NoelGaspar/cinnda_oval_hardware/board/Output_files/oval_v5.step

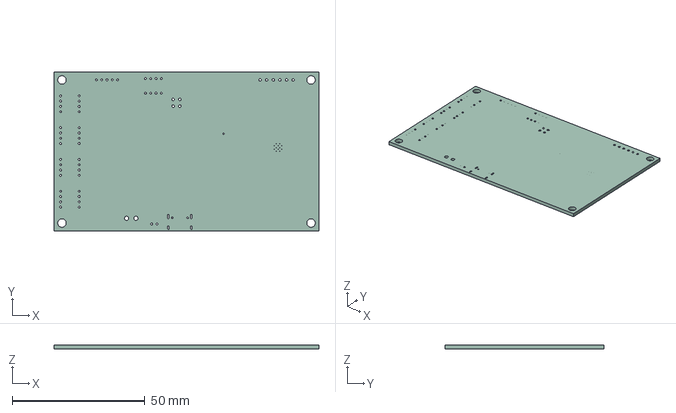
[picture p1: CAD file, 2026-07-07]
board/Output_files/oval_v5.step
100.0 x 60.0 x 1.51 mm
