NoelGaspar/cinnda_oval_hardware/board/oval_v5.kicad_pcb

## KiCad design board/oval_v5.kicad_pcb (2026-07-07)

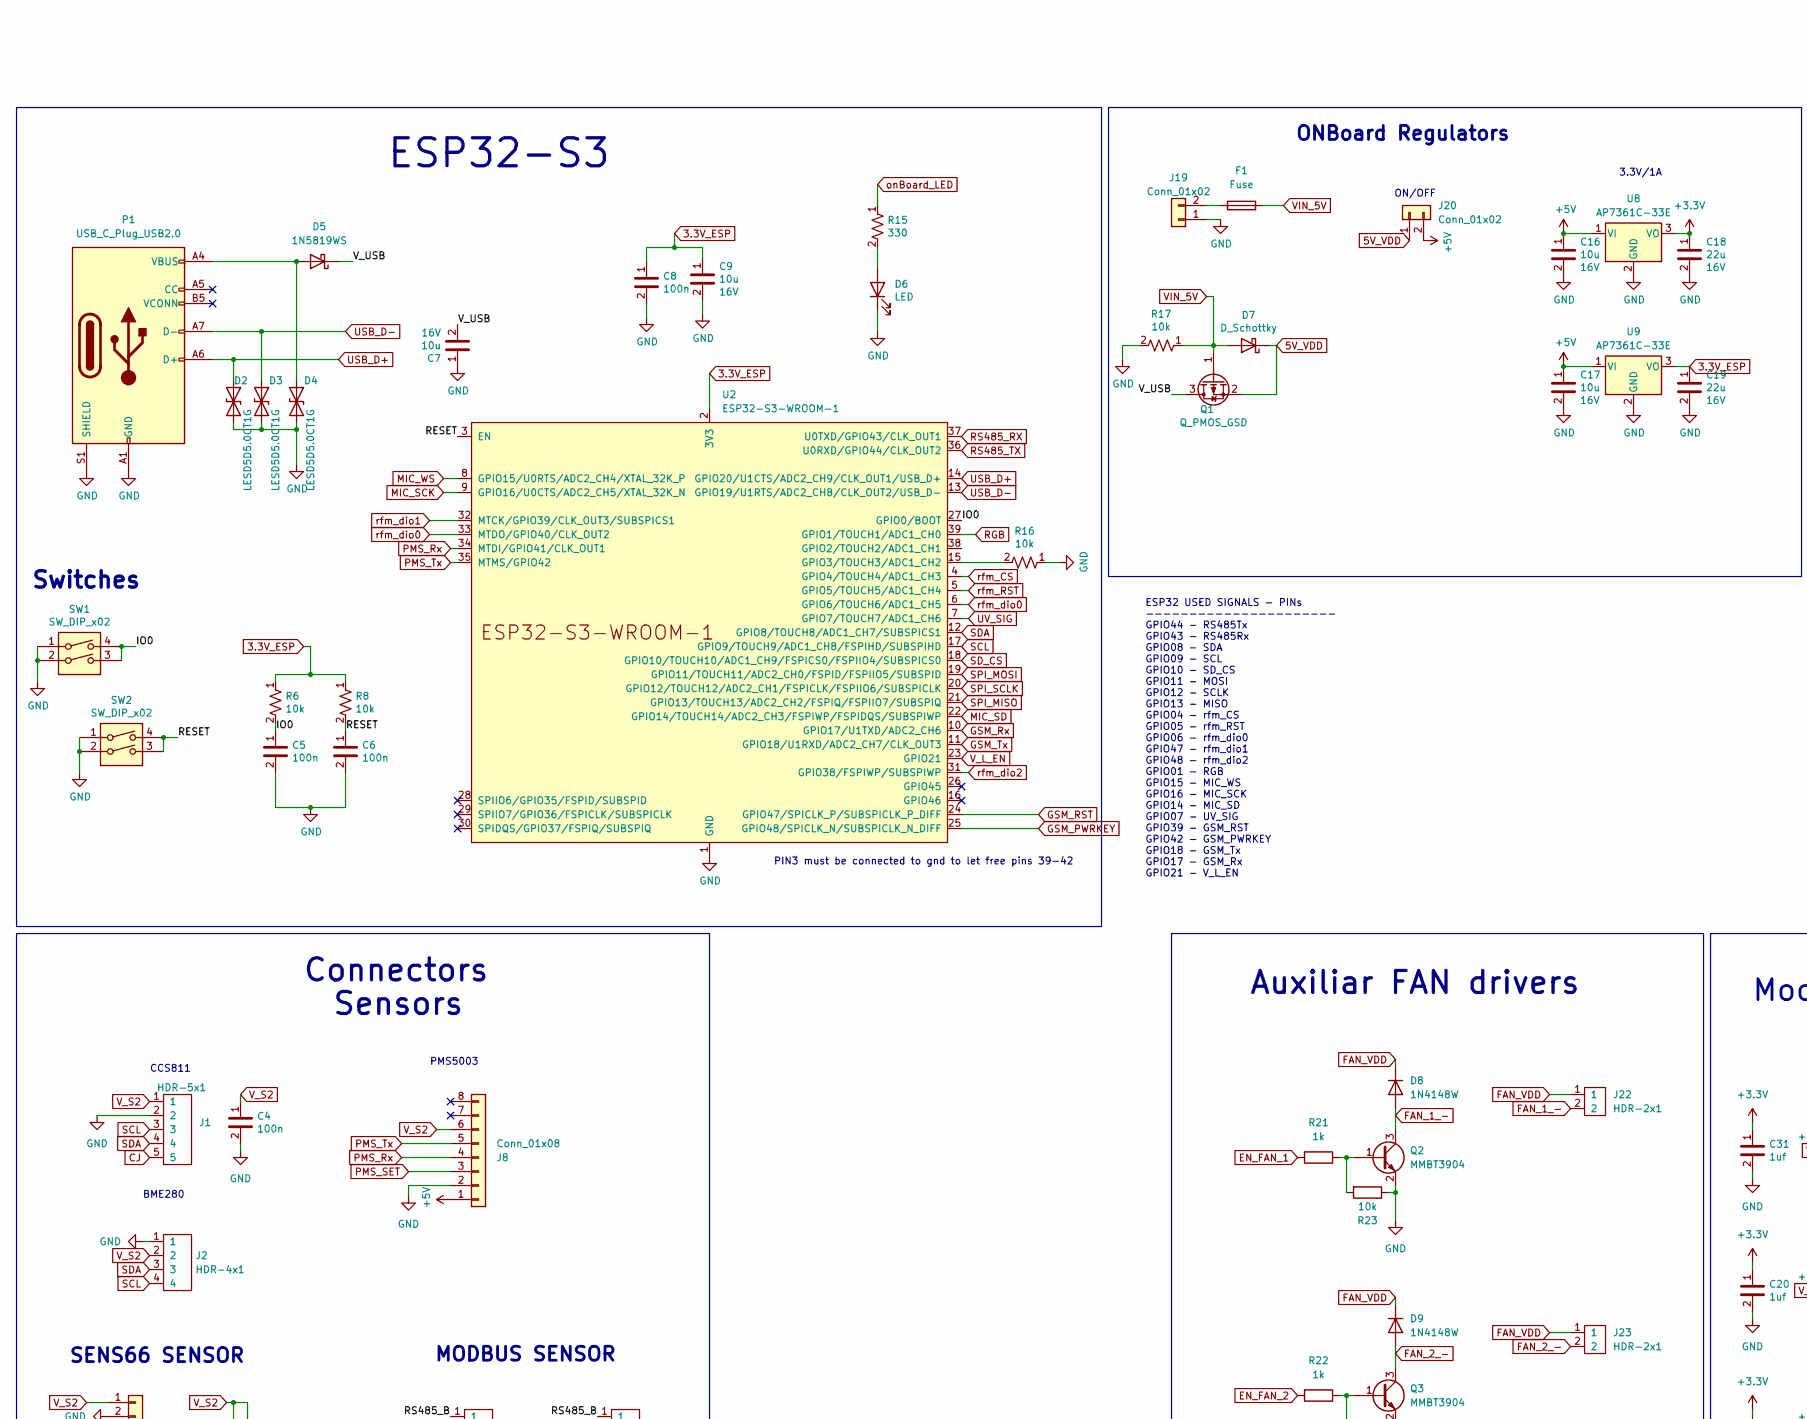
[picture p2: schematic oval_v5.kicad_sch, part in row 1, column 1]

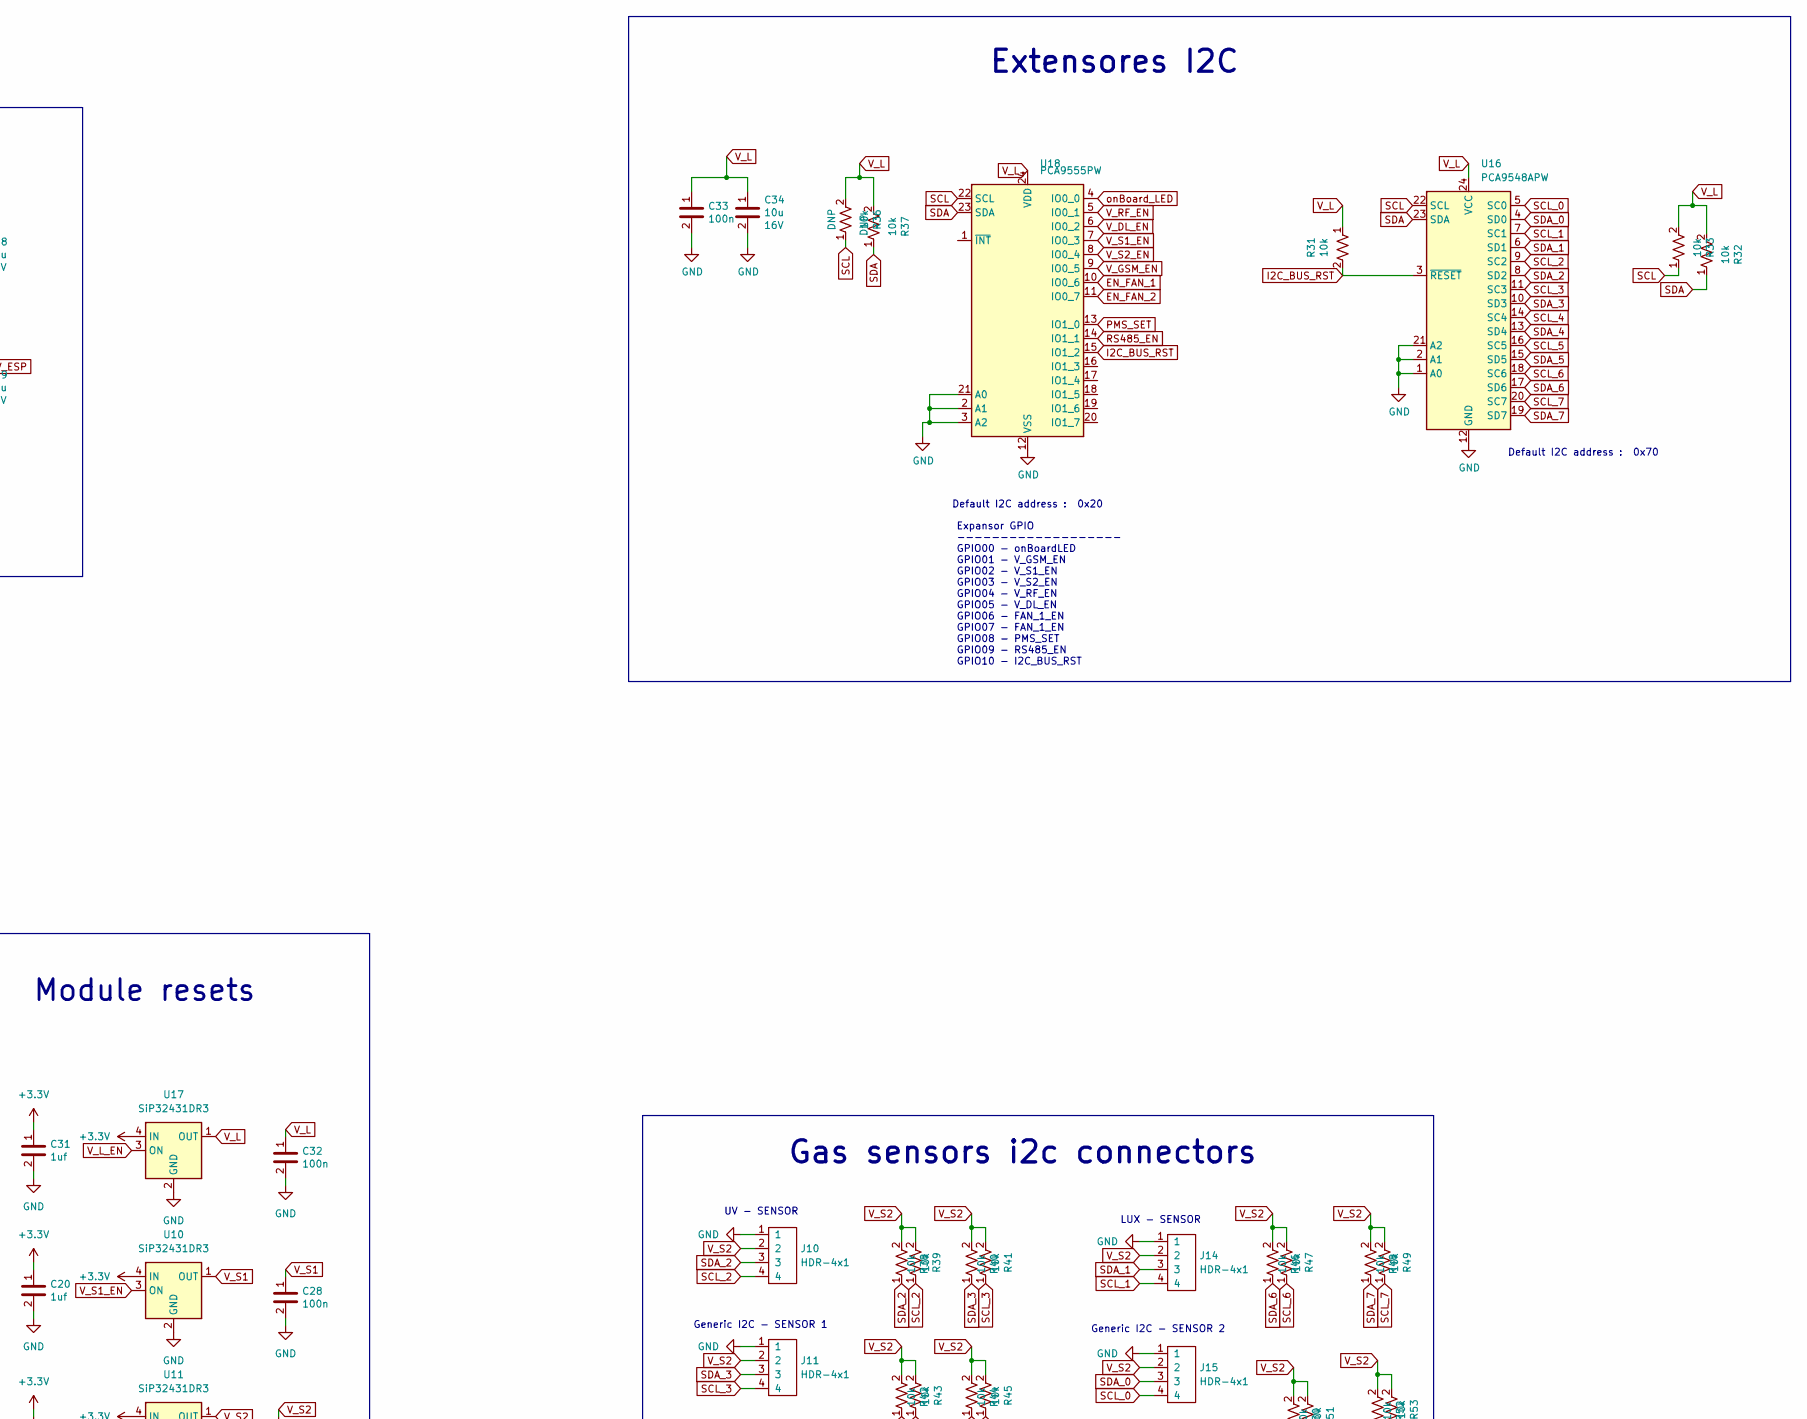
[picture p3: schematic oval_v5.kicad_sch, part in row 1, column 2]

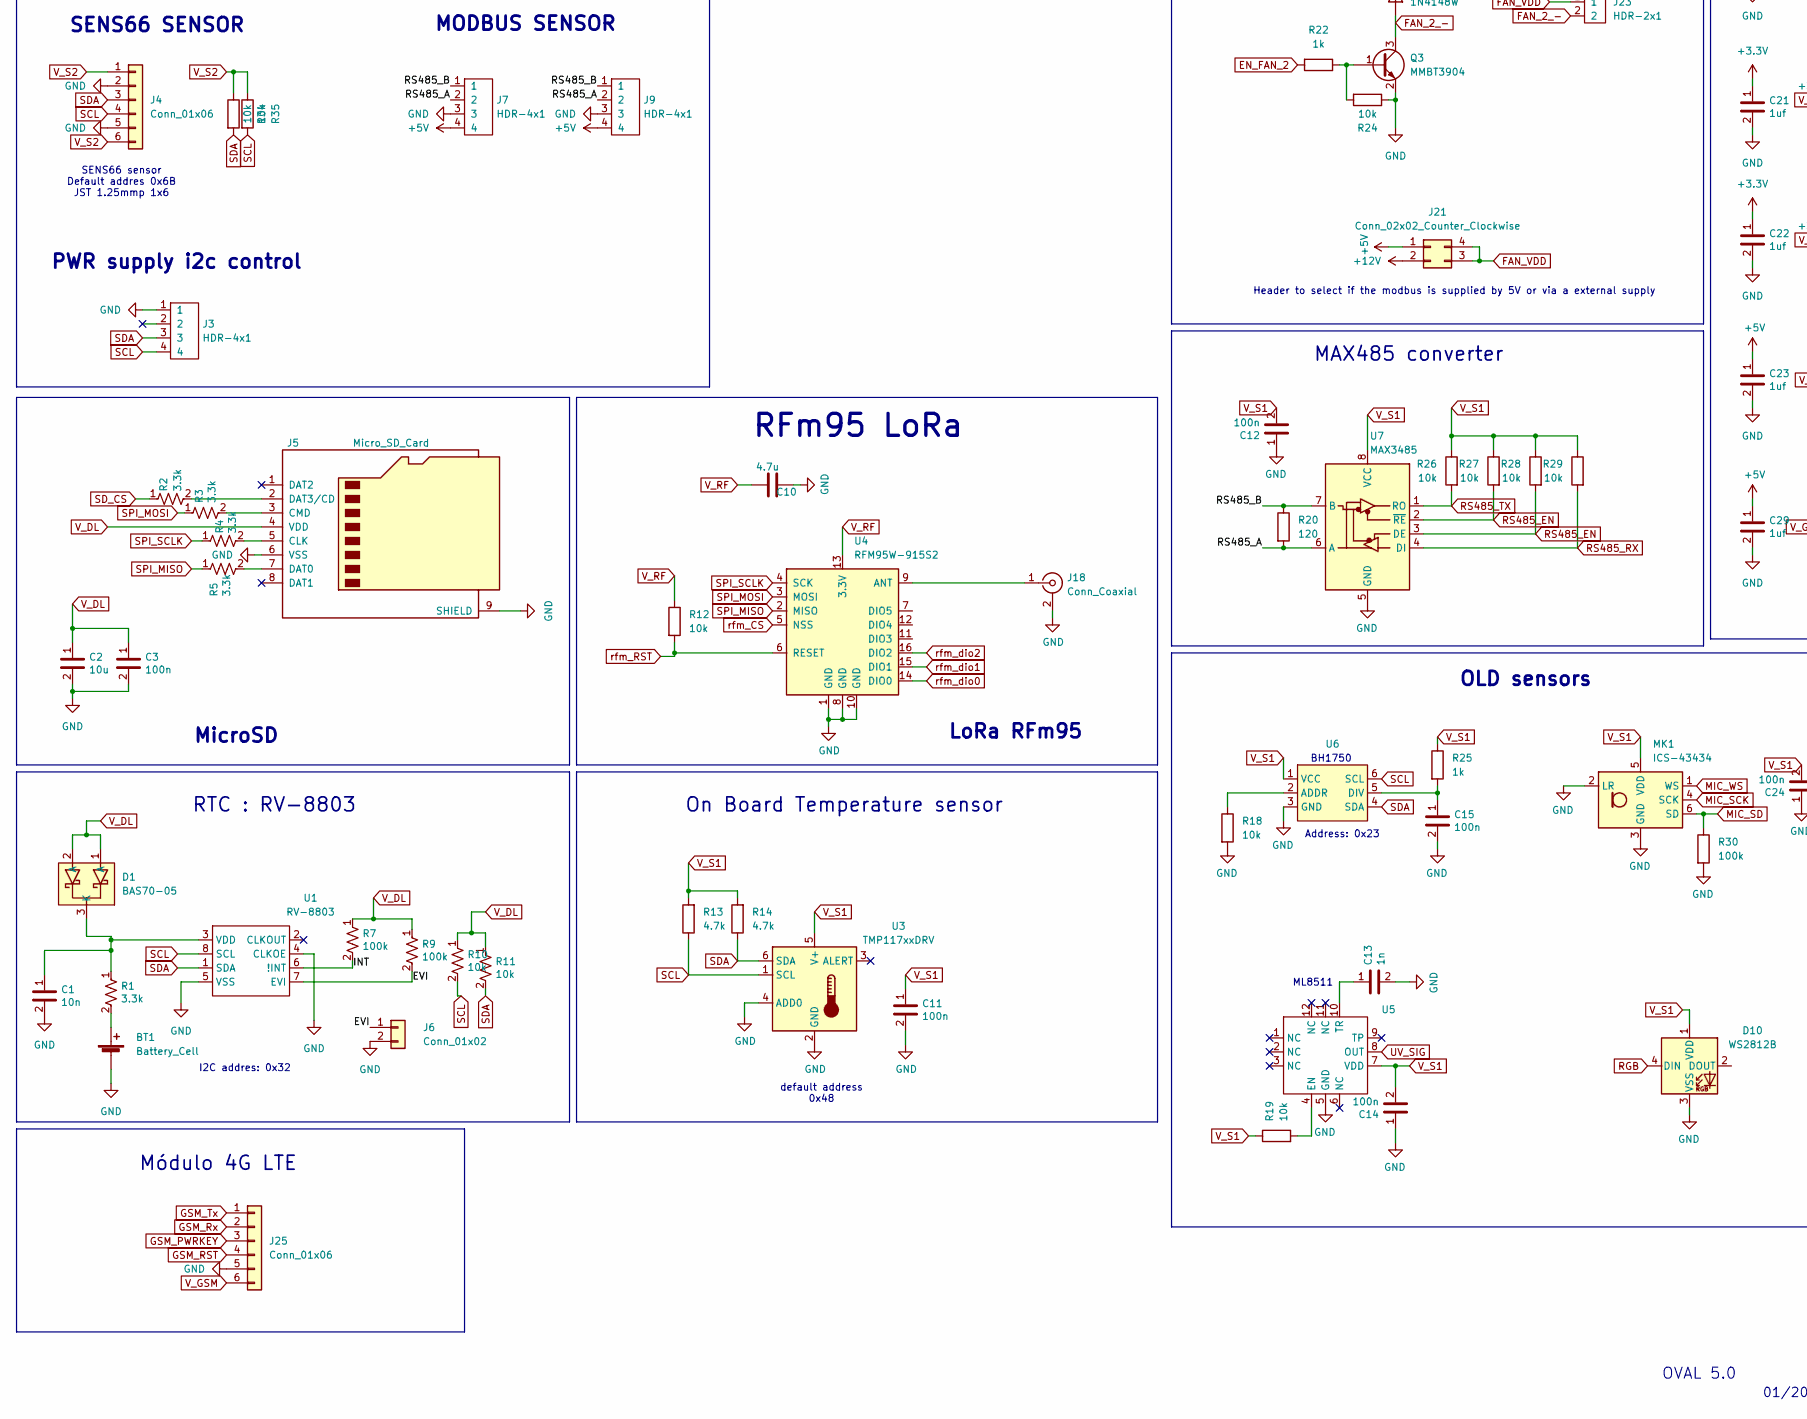
[picture p4: schematic oval_v5.kicad_sch, part in row 2, column 1]

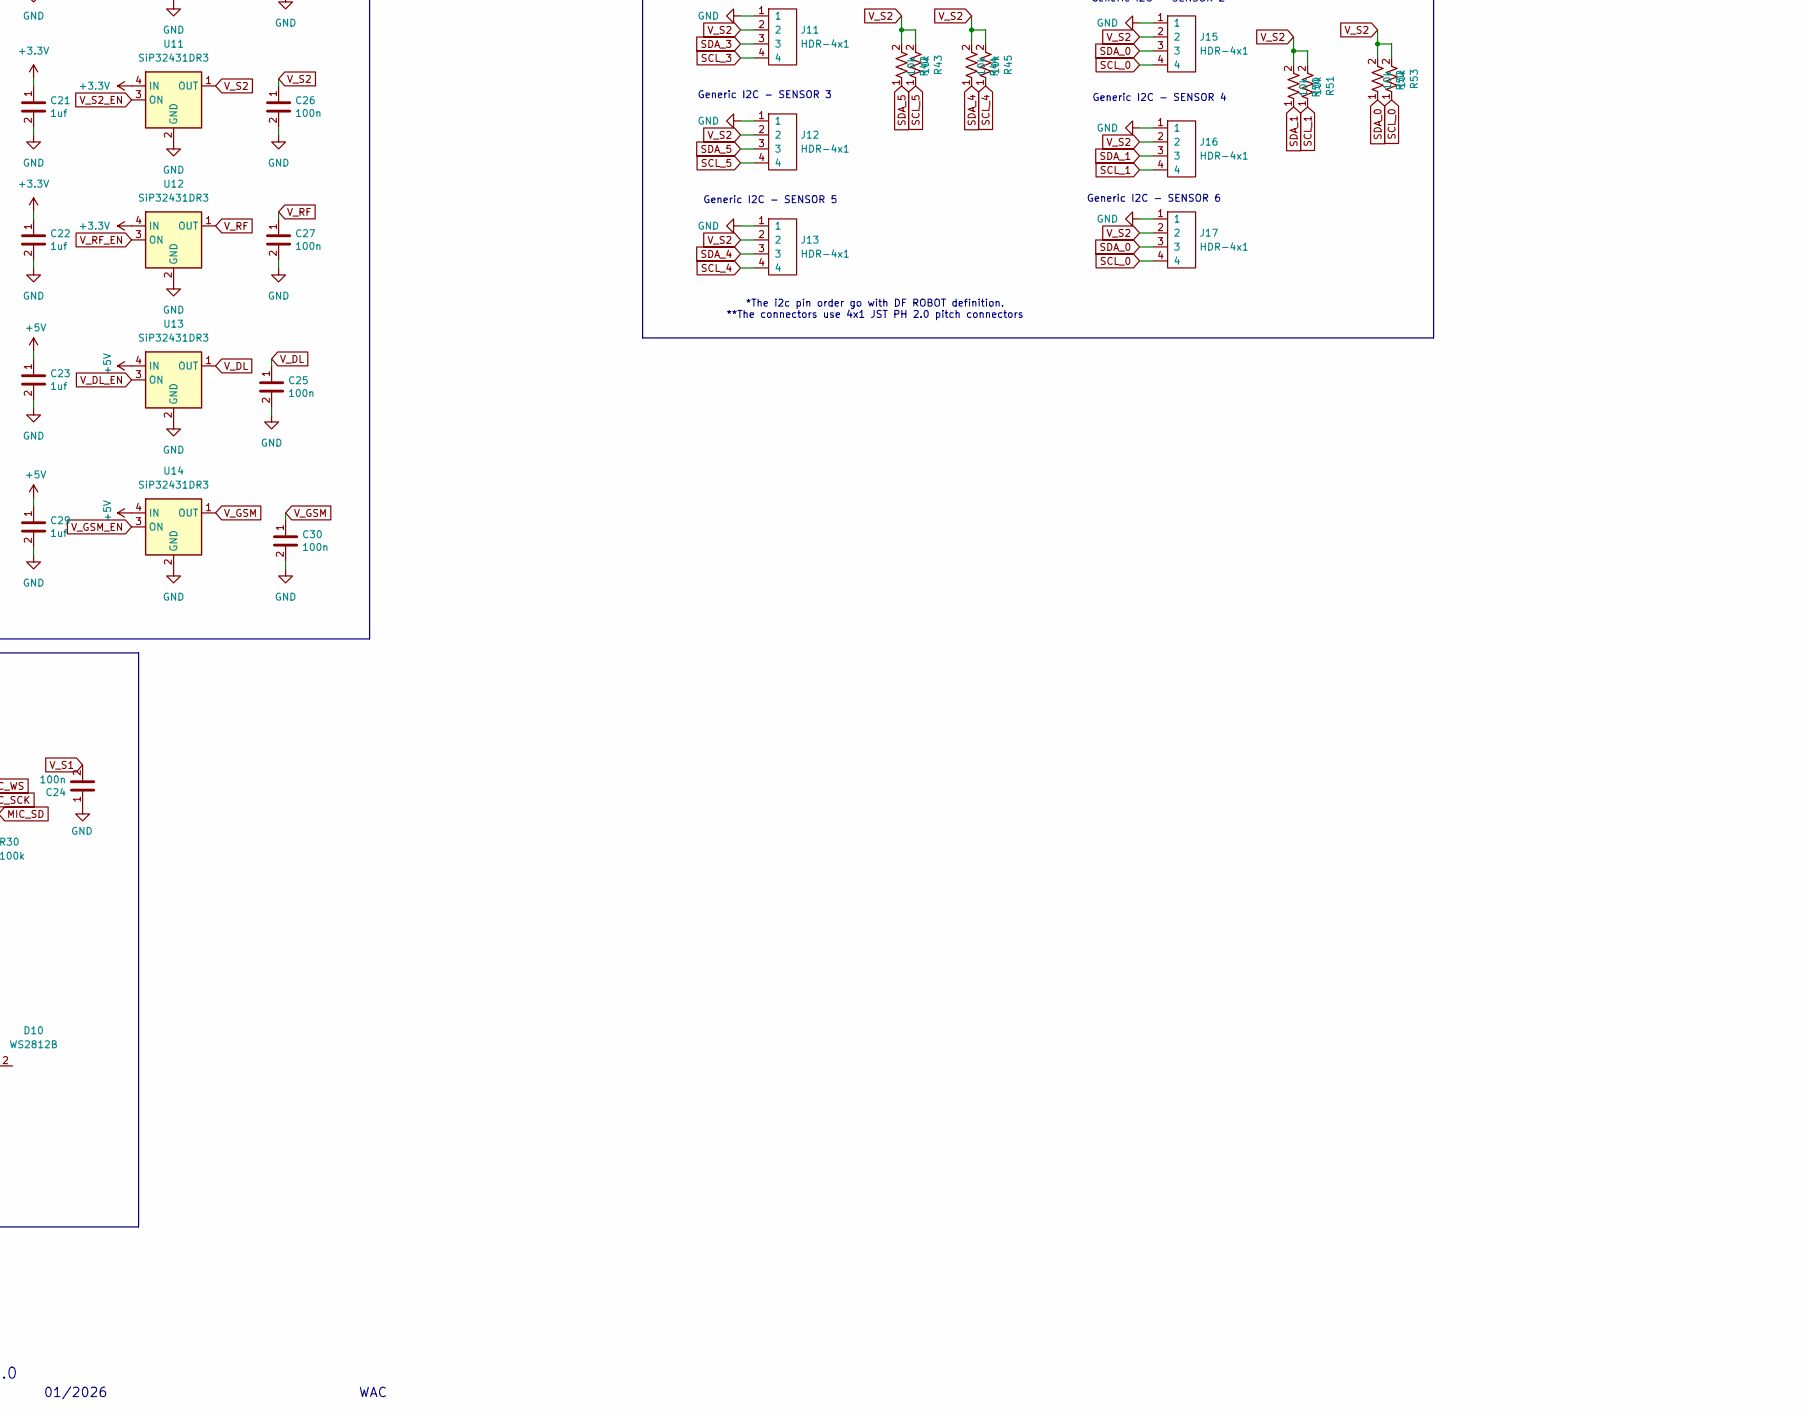
[picture p5: schematic oval_v5.kicad_sch, part in row 2, column 2]

Parts:
BT1: Battery_Cell; BatteryHolder_Keystone_3000_1x12mm
C1: 10n; C_0603_1608Metric; Voltage rated 16V
C2, C7, C9, C16, C17, C34: 10u; C_0805_2012Metric; Voltage rated 16V
C3, C4, C5, C6, C8, C11, C12, C14, C15, C24, C25, C26, C27, C28, C30, C32, C33: 100n; C_0603_1608Metric; Voltage rated 16V
C10: 4.7u; C_0805_2012Metric
C13: 1n; C_0603_1608Metric; Voltage rated 16V
C18, C19: 22u; C_0805_2012Metric; Voltage rated 16V
C20, C21, C22, C23, C29, C31: 1uf; C_0805_2012Metric; Voltage rated 16V
D1: BAS70-05; SOT-23
D2, D3, D4: LESD5D5.0CT1G; D_SOD-523
D5: 1N5819WS; D_SOD-323_HandSoldering
D6: LED; LED_0603_1608Metric
D7: D_Schottky; D_SMA
D8, D9: 1N4148W; D_SOD-123
D10: WS2812B; LED_WS2812B_PLCC4_5.0x5.0mm_P3.2mm
F1: Fuse; Fuse_1206_3216Metric
J1: HDR-5x1; JST_PH_B5B-PH-K_1x05_P2.00mm_Vertical
J2, J3: HDR-4x1; JST_SH_SM04B-SRSS-TB_1x04-1MP_P1.00mm_Horizontal
J4: Conn_01x06; JST_GH_SM06B-GHS-TB_1x06-1MP_P1.25mm_Horizontal
J5: Micro_SD_Card; microSD_HC_Wuerth_693072010801
J6: Conn_01x02; SolderJumper-2_P1.3mm_Open_RoundedPad1.0x1.5mm
J7, J9, J10, J11, J12, J13, J14, J15, J16, J17: HDR-4x1; JST_PH_B4B-PH-K_1x04_P2.00mm_Vertical
J8: Conn_01x08; Molex_PicoBlade_53261-0871_1x08-1MP_P1.25mm_Horizontal
J18: Conn_Coaxial; U.FL_Molex_MCRF_73412-0110_Vertical
J19: Conn_01x02; Wago_734-132_1x02_P3.50mm_Vertical
J20: Conn_01x02; JST_PH_B2B-PH-K_1x02_P2.00mm_Vertical
J21: Conn_02x02_Counter_Clockwise; PinHeader_2x02_P2.54mm_Vertical
J22, J23: HDR-2x1; JST_PH_S2B-PH-SM4-TB_1x02-1MP_P2.00mm_Horizontal
J25: Conn_01x06; JST_PH_B6B-PH-K_1x06_P2.00mm_Vertical
MK1: ICS-43434; InvenSense_ICS-43434-6_3.5x2.65mm
P1: USB_C_Plug_USB2.0; USB_C_Receptacle_GCT_USB4105-xx-A_16P_TopMnt_Horizontal
Q1: Q_PMOS_GSD; SOT-23
Q2, Q3: MMBT3904; SOT-23
R1, R2, R3, R4, R5: 3.3k; R_0603_1608Metric
R6, R8, R10, R11, R12, R16, R17, R18, R19, R23, R24, R26, R27, R28, R29, R31, R32, R33, R34, R35, R36, R37, R38, R39, R40, R41, R42, R43, R44, R45, R46, R47, R48, R49, R50, R51, R52, R53: 10k; R_0603_1608Metric
R7, R9, R30: 100k; R_0603_1608Metric
R13, R14: 4.7k; R_0603_1608Metric
R15: 330; R_0603_1608Metric
R20: 120; R_0603_1608Metric
R21, R22, R25: 1k; R_0603_1608Metric
SW1, SW2: SW_DIP_x02; SMD_SWITCH
U1: RV-8803; SON-8
U2: ESP32-S3-WROOM-1
U3: TMP117xxDRV; WSON-6-1EP_2x2mm_P0.65mm_EP1x1.6mm
U4: RFM95W-915S2; HOPERF_RFM9XW_SMD
U5: C-TQFN12-4.0x3.7-1
U6: WSOF6I
U7: MAX3485; SOP-8_3.9x4.9mm_P1.27mm
U8, U9: AP7361C-33E; SOT-223-3_TabPin2
U10, U11, U12, U13, U14, U17: SiP32431DR3; SOT-363_SC-70-6
U16: PCA9548APW; TSSOP-24_4.4x7.8mm_P0.65mm
U18: PCA9555PW; TSSOP-24_4.4x7.8mm_P0.65mm

Connections:
3.3V_ESP: C8.1, C9.1, C19.1, R6.1, R8.1, U2.2 (3V3), U9.3 (VO)
5V_VDD: D7.1 (K), J20.1, Q1.2 (S)
+3.3V: C18.1, C20.1, C21.1, C22.1, C31.1, U8.3 (VO), U10.4 (IN), U11.4 (IN), U12.4 (IN), U17.4 (IN)
+5V: C16.1, C17.1, C23.1, C29.1, J7.4, J8.1, J9.4, J20.2, J21.1, U8.1 (VI), U9.1 (VI), U13.4 (IN), U14.4 (IN)
+12V: J21.2
/EVI: J6.1, R9.2, U1.7 (EVI)
/INT: R7.2, U1.6 (!INT)
/IO0: C5.1, R6.2, SW1.3, SW1.4, U2.27 (GPIO0/BOOT)
/RESET: C6.1, R8.2, SW2.3, SW2.4, U2.3 (EN)
/RS485_A: J7.2, J9.2, R20.2, U7.6 (A)
/RS485_B: J7.1, J9.1, R20.1, U7.7 (B)
/V_USB: C7.2, D5.1 (K), Q1.3 (D)
CJ: J1.5
EN_FAN_1: R21.2, U18.10 (IO0_6)
EN_FAN_2: R22.2, U18.11 (IO0_7)
FAN_1_-: D8.2 (A), J22.2, Q2.3 (C)
FAN_2_-: D9.2 (A), J23.2, Q3.3 (C)
FAN_VDD: D8.1 (K), D9.1 (K), J21.3, J21.4, J22.1, J23.1
GND: BT1.2 (-), C1.2, C2.2, C3.2, C4.2, C5.2, C6.2, C7.1, C8.2, C9.2, C10.1, C11.2, C12.1, C13.2, C14.1, C15.2, C16.2, C17.2, C18.2, C19.2, C20.2, C21.2, C22.2, C23.2, C24.1, C25.2, C26.2, C27.2, C28.2, C29.2, C30.2, C31.2, C32.2, C33.2, C34.2, D2.2 (A2), D3.2 (A2), D4.2 (A2), D6.1 (K), D10.3 (VSS), J1.2, J2.1, J3.1, J4.2, J4.5, J5.6 (VSS), J5.9 (SHIELD), J6.2, J7.3, J8.2, J9.3, J10.1, J11.1, J12.1, J13.1, J14.1, J15.1, J16.1, J17.1, J18.2 (Ext), J19.1, J25.5, MK1.2 (LR), MK1.3 (GND), P1.A1 (GND), P1.A12 (GND), P1.B1 (GND), P1.B12 (GND), P1.S1 (SHIELD), Q2.2 (E), Q3.2 (E), R16.1, R17.2, R18.2, R23.1, R24.1, R30.2, SW1.1, SW1.2, SW2.1, SW2.2, U1.4 (CLKOE), U1.5 (VSS), U2.1 (GND), U2.40 (GND), U2.41 (GND), U3.2 (GND), U3.4 (ADD0), U4.1 (GND), U4.8 (GND), U4.10 (GND), U5.5 (GND), U6.3 (GND), U7.5 (GND), U8.2 (GND), U9.2 (GND), U10.2 (GND), U10.5 (GND), U11.2 (GND), U11.5 (GND), U12.2 (GND), U12.5 (GND), U13.2 (GND), U13.5 (GND), U14.2 (GND), U14.5 (GND), U16.1 (A0), U16.2 (A1), U16.12 (GND), U16.21 (A2), U17.2 (GND), U17.5 (GND), U18.2 (A1), U18.3 (A2), U18.12 (VSS), U18.21 (A0)
GSM_PWRKEY: J25.3, U2.25 (GPIO48/SPICLK_N/SUBSPICLK_N_DIFF)
GSM_RST: J25.4, U2.24 (GPIO47/SPICLK_P/SUBSPICLK_P_DIFF)
GSM_Rx: J25.2, U2.10 (GPIO17/U1TXD/ADC2_CH6)
GSM_Tx: J25.1, U2.11 (GPIO18/U1RXD/ADC2_CH7/CLK_OUT3)
I2C_BUS_RST: R31.2, U16.3 (~RESET), U18.15 (IO1_2)
MIC_SCK: MK1.4 (SCK), U2.9 (GPIO16/U0CTS/ADC2_CH5/XTAL_32K_N)
MIC_SD: MK1.6 (SD), R30.1, U2.22 (GPIO14/TOUCH14/ADC2_CH3/FSPIWP/FSPIDQS/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)
MIC_WS: MK1.1 (WS), U2.8 (GPIO15/U0RTS/ADC2_CH4/XTAL_32K_P)
unnamed: BT1.1 (+), R1.2
unnamed: C1.1, D1.3 (K), R1.1, U1.3 (VDD)
unnamed: D4.1 (A1), D5.2 (A), P1.A4 (VBUS), P1.A9 (VBUS), P1.B4 (VBUS), P1.B9 (VBUS)
unnamed: D6.2 (A), R15.2
unnamed: J5.5 (CLK), R4.2
unnamed: J5.3 (CMD), R3.2
unnamed: J5.7 (DAT0), R5.2
unnamed: J5.2 (DAT3/CD), R2.2
unnamed: J18.1 (In), U4.9 (ANT)
unnamed: F1.1, J19.2
unnamed: Q2.1 (B), R21.1, R23.2
unnamed: Q3.1 (B), R22.1, R24.2
unnamed: R16.2, U2.15 (GPIO3/TOUCH3/ADC1_CH2)
unnamed: R19.2, U5.4 (EN)
unnamed: C13.1, U5.10 (TR)
unnamed: R18.1, U6.2 (ADDR)
unnamed: C15.1, R25.2, U6.5 (DIV)
PMS_Rx: J8.4, U2.34 (MTDI/GPIO41/CLK_OUT1)
PMS_SET: J8.3, U18.13 (IO1_0)
PMS_Tx: J8.5, U2.35 (MTMS/GPIO42)
RGB: D10.4 (DIN), U2.39 (GPIO1/TOUCH1/ADC1_CH0)
RS485_EN: R27.2, R28.2, U7.2 (~RE), U7.3 (DE), U18.14 (IO1_1)
RS485_RX: R29.2, U2.37 (U0TXD/GPIO43/CLK_OUT1), U7.4 (DI)
RS485_TX: R26.2, U2.36 (U0RXD/GPIO44/CLK_OUT2), U7.1 (RO)
SCL: J1.3, J2.4, J3.4, J4.4, R10.2, R13.1, R33.1, R35.2, R36.1, U1.8 (SCL), U2.17 (GPIO9/TOUCH9/ADC1_CH8/FSPIHD/SUBSPIHD), U3.1 (SCL), U6.6 (SCL), U16.22 (SCL), U18.22 (SCL)
SCL_0: J15.4, J17.4, R53.1, U16.5 (SC0)
SCL_1: J14.4, J16.4, R51.1, U16.7 (SC1)
SCL_2: J10.4, R39.1, U16.9 (SC2)
SCL_3: J11.4, R41.1, U16.11 (SC3)
SCL_4: J13.4, R45.1, U16.14 (SC4)
SCL_5: J12.4, R43.1, U16.16 (SC5)
SCL_6: R47.1, U16.18 (SC6)
SCL_7: R49.1, U16.20 (SC7)
SDA: J1.4, J2.3, J3.3, J4.3, R11.2, R14.1, R32.1, R34.2, R37.1, U1.1 (SDA), U2.12 (GPIO8/TOUCH8/ADC1_CH7/SUBSPICS1), U3.6 (SDA), U6.4 (SDA), U16.23 (SDA), U18.23 (SDA)
SDA_0: J15.3, J17.3, R52.1, U16.4 (SD0)
SDA_1: J14.3, J16.3, R50.1, U16.6 (SD1)
SDA_2: J10.3, R38.1, U16.8 (SD2)
SDA_3: J11.3, R40.1, U16.10 (SD3)
SDA_4: J13.3, R44.1, U16.13 (SD4)
SDA_5: J12.3, R42.1, U16.15 (SD5)
SDA_6: R46.1, U16.17 (SD6)
SDA_7: R48.1, U16.19 (SD7)
SD_CS: R2.1, U2.18 (GPIO10/TOUCH10/ADC1_CH9/FSPICS0/FSPIIO4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)
SPI_MISO: R5.1, U2.21 (GPIO13/TOUCH13/ADC2_CH2/FSPIQ/FSPIIO7/S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), U4.2 (MISO)
SPI_MOSI: R3.1, U2.19 (GPIO11/TOUCH11/ADC2_CH0/FSPID/FSPIIO5/S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), U4.3 (MOSI)
SPI_SCLK: R4.1, U2.20 (GPIO12/TOUCH12/ADC2_CH1/FSPICLK/FSPIIO6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), U4.4 (SCK)
USB_D+: D2.1 (A1), P1.A6 (D+), U2.14 (GPIO20/U1CTS/ADC2_CH9/CLK_OUT1/USB_D+)
USB_D-: D3.1 (A1), P1.A7 (D-), U2.13 (GPIO19/U1RTS/ADC2_CH8/CLK_OUT2/USB_D-)
UV_SIG: U2.7 (GPIO7/TOUCH7/ADC1_CH6), U5.8 (OUT)
VIN_5V: D7.2 (A), F1.2, Q1.1 (G), R17.1
V_DL: C2.1, C3.1, C25.1, D1.1 (A), D1.2 (A), J5.4 (VDD), R7.1, R9.1, R10.1, R11.1, U13.1 (OUT)
V_DL_EN: U13.3 (ON), U18.6 (IO0_2)
V_GSM: C30.1, J25.6, U14.1 (OUT)
V_GSM_EN: U14.3 (ON), U18.9 (IO0_5)
V_L: C32.1, C33.1, C34.1, R31.1, R32.2, R33.2, R36.2, R37.2, U16.24 (VCC), U17.1 (OUT), U18.24 (VDD)
V_L_EN: U2.23 (GPIO21), U17.3 (ON)
V_RF: C10.2, C27.1, R12.1, U4.13 (3.3V), U12.1 (OUT)
V_RF_EN: U12.3 (ON), U18.5 (IO0_1)
V_S1: C11.1, C12.2, C14.2, C24.2, C28.1, D10.1 (VDD), MK1.5 (VDD), R13.2, R14.2, R19.1, R25.1, R26.1, R27.1, R28.1, R29.1, U3.5 (V+), U5.7 (VDD), U6.1 (VCC), U7.8 (VCC), U10.1 (OUT)
V_S1_EN: U10.3 (ON), U18.7 (IO0_3)
V_S2: C4.1, C26.1, J1.1, J2.2, J4.1, J4.6, J8.6, J10.2, J11.2, J12.2, J13.2, J14.2, J15.2, J16.2, J17.2, R34.1, R35.1, R38.2, R39.2, R40.2, R41.2, R42.2, R43.2, R44.2, R45.2, R46.2, R47.2, R48.2, R49.2, R50.2, R51.2, R52.2, R53.2, U11.1 (OUT)
V_S2_EN: U11.3 (ON), U18.8 (IO0_4)
onBoard_LED: R15.1, U18.4 (IO0_0)
rfm_CS: U2.4 (GPIO4/TOUCH4/ADC1_CH3), U4.5 (NSS)
rfm_RST: R12.2, U2.5 (GPIO5/TOUCH5/ADC1_CH4), U4.6 (RESET)
rfm_dio0: U2.6 (GPIO6/TOUCH6/ADC1_CH5), U2.33 (MTDO/GPIO40/CLK_OUT2), U4.14 (DIO0)
rfm_dio1: U2.32 (MTCK/GPIO39/CLK_OUT3/SUBSPICS1), U4.15 (DIO1)
rfm_dio2: U2.31 (GPIO38/FSPIWP/SUBSPIWP), U4.16 (DIO2)

Notes on the sheet:
Address: 0x23
Header to select if the modbus is supplied by 5V or via a external supply
Generic I2C - SENSOR 6
ESP32 USED SIGNALS - PINs ---------------------- GPIO44 - RS485Tx GPIO43 - RS485Rx GPIO08 - SDA GPIO09 - SCL GPIO10 - SD_CS GPIO11 - MOSI GPIO12 - SCLK GPIO13 - MISO GPIO04 - rfm_CS GPIO05 - rfm_RST GPIO06 - rfm_dio0 GPIO47 - rfm_dio1 GPIO48 - rfm_dio2 GPIO01 - RGB GPIO15 - MIC_WS GPIO16 - MIC_SCK 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
Generic I2C - SENSOR 1
On Board Temperature sensor
ESP32-S3
UV - SENSOR
MODBUS SENSOR
PWR supply i2c control
MicroSD
Generic I2C - SENSOR 4
ON/OFF
Generic I2C - SENSOR 5
WAC
Module resets
Generic I2C - SENSOR 2
PMS5003
Switches
OVAL 5.0
ONBoard Regulators
Expansor GPIO ------------------- GPIO00 - onBoardLED GPIO01 - V_GSM_EN GPIO02 - V_S1_EN GPIO03 - V_S2_EN GPIO04 - V_RF_EN GPIO05 - V_DL_EN GPIO06 - FAN_1_EN GPIO07 - FAN_1_EN GPIO08 - PMS_SET GPIO09 - RS485_EN GPIO10 - I2C_BUS_RST
SENS66 SENSOR
BH1750
OLD sensors
01/2026
LoRa RFm95
Sensors
*The i2c pin order go with DF ROBOT definition. **The connectors use 4x1 JST PH 2.0 pitch connectors
LUX - SENSOR
Gas sensors i2c connectors
ML8511
Default I2C address : 0x20
SENS66 sensor Default addres 0x6B JST 1.25mmp 1x6
PIN3 must be connected to gnd to let free pins 39-42
Generic I2C - SENSOR 3
Connectors
BME280
Default I2C address : 0x70
RTC : RV-8803
CCS811
Extensores I2C
Auxiliar FAN drivers
Módulo 4G LTE
3.3V/1A
I2C addres: 0x32
MAX485 converter
RFm95 LoRa
default address 0x48

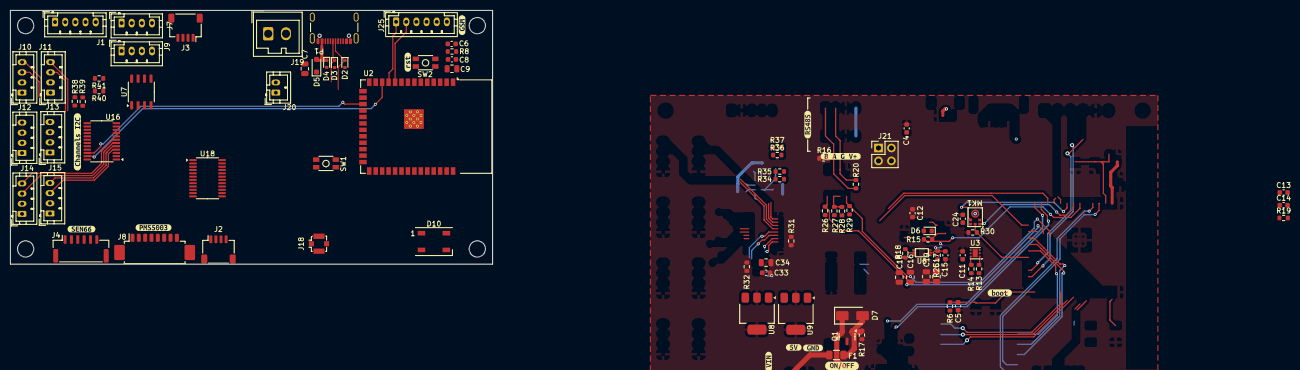
[picture p6: board oval_v5.kicad_pcb from above]

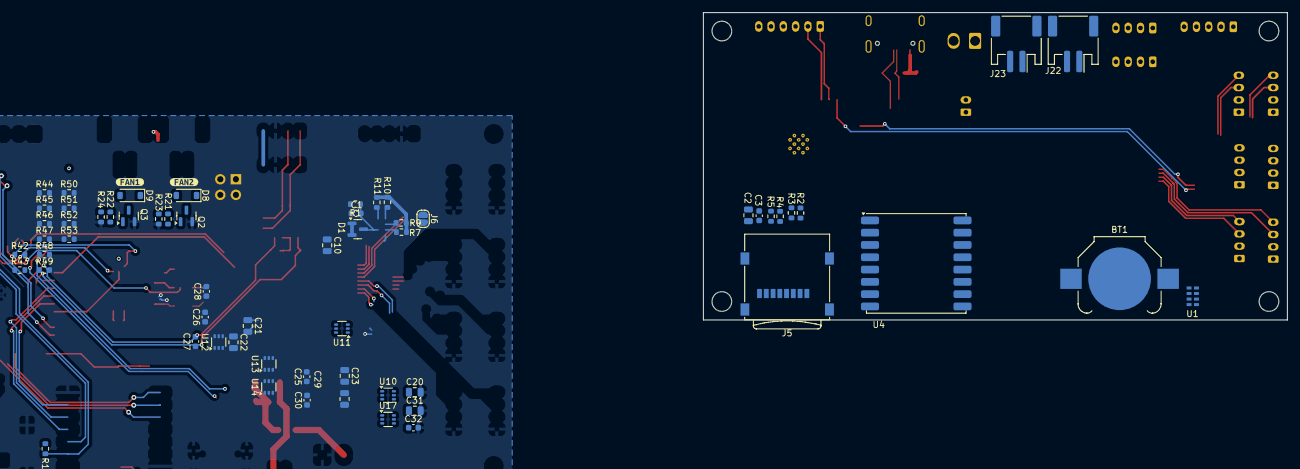
[picture p7: board oval_v5.kicad_pcb from below]

Board: 4 copper layers, 95.0 x 50.0 mm, 157 parts (62 on the bottom side), 90 nets.

Other parts of the board:
kibuzzard-69A867E5: G***; kibuzzard-69A867E5
kibuzzard-69A86736: G***; kibuzzard-69A86736
kibuzzard-69B0484A: G***; kibuzzard-69B0484A
kibuzzard-69B0485B: G***; kibuzzard-69B0485B
kibuzzard-69B0486A: G***; kibuzzard-69B0486A
kibuzzard-69B04879: G***; kibuzzard-69B04879
kibuzzard-699C8DA6: G***; kibuzzard-699C8DA6
kibuzzard-699C8DCD: G***; kibuzzard-699C8DCD
kibuzzard-6994EF08: G***; kibuzzard-6994EF08
kibuzzard-6994F00B: G***; kibuzzard-6994F00B
kibuzzard-6994F01D: G***; kibuzzard-6994F01D
kibuzzard-6994F21E: G***; kibuzzard-6994F21E
kibuzzard-69934830: G***; kibuzzard-69934830
kibuzzard-69934843: G***; kibuzzard-69934843
