NoelGaspar/cinnda_oval_hardware/(commit log)

2026-02-02 working on schematic, main componentes defined
    [oval_v5.kicad_pcb, oval_v5.kicad_sch]
2026-02-12 starting layout
    [oval_v5.kicad_pcb]
2026-02-13 commponent placement finished
    [oval_v5.kicad_pcb]
2026-02-20 minor changes
    [oval_v5.kicad_sch]
2026-02-23 working on layout - defining connectors and cables
    [oval_v5 bkp.kicad_pcb, oval_v5.kicad_pcb, oval_v5.kicad_sch]
2026-02-25 assignint pines
    [oval_v5.kicad_pcb, oval_v5.kicad_sch]
2026-03-02 updateing 27/02
    [oval_v5.kicad_pcb, oval_v5.kicad_sch]
2026-03-04 adding layout review
    [oval_v5.kicad_pcb, oval_v5.kicad_sch]
2026-03-09 routing pads
    [oval_v5.kicad_pcb, oval_v5.kicad_sch]
2026-03-10 i2c multiplexer routed
    [oval_v5.kicad_pcb, oval_v5.kicad_sch]
2026-03-11 i2c adding pull up resistors
    [oval_v5.kicad_pcb, oval_v5.kicad_sch]
2026-03-13 adding work in layout
    [oval_v5.csv, oval_v5.kicad_pcb, oval_v5.kicad_sch]
2026-03-18 bom ready
    [oval_v5.csv, oval_v5.kicad_sch]
2026-03-24 working on bom
    [oval_v5.csv]
2026-03-25 bom already finished
    [export_cart_20260325_230156.csv, oval_v5.csv, oval_v5.kicad_sch]
2026-03-26 cart finished and upload to the provider
    [export_cart_20260325_230156.csv, oval_v5.csv]
2026-07-07 generating step
    [oval_v5 bkp.kicad_pcb, oval_v5.csv, oval_v5.kicad_pcb, oval_v5.step]
2026-07-07 working on board
    [oval_v5 bkp.kicad_pcb, oval_v5.kicad_pcb, oval_v5.kicad_sch]
2026-07-20 Working on pcb layouy
